romainrossi/make_your_robot_tick/contest rules/game field 3D view.png

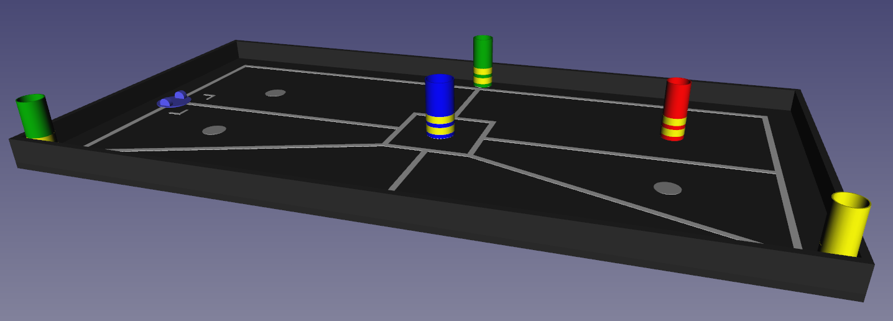
contest rules/game field 3D view.png
