romainrossi/make_your_robot_tick/contest rules/source 3D view.png

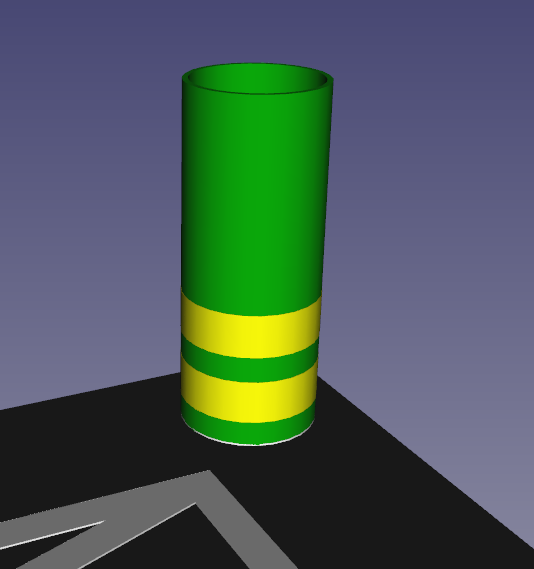
contest rules/source 3D view.png
