romainrossi/make_your_robot_tick/README.md

# Make Your Robot Tick

A robotic contest organized by [ESIGELEC](http://esigelec.fr/en).

# Status

The contest is now closed; thanks to all the participants.
