romainrossi/make_your_robot_tick/contest rules/README.md

# Make Your Robot Tick - Rules

This directory contains the official rules document and associated technical documentation : pictures, drawings and schematics of the game field elements.
