romainrossi/make_your_robot_tick/src/elec/README.md

# Make Your Robot Tick - Electronics CAD files

This directory contains a KiCAD project for the electronic boards used on the game field.
