romainrossi/make_your_robot_tick/src/meca/README.md

# Make Your Robot Tick - Mechanical CAD files

This directory contains a FreeCAD project design of the game field and associated elements.
