romainrossi/make_your_robot_tick/contest rules/source activation timing.pdf

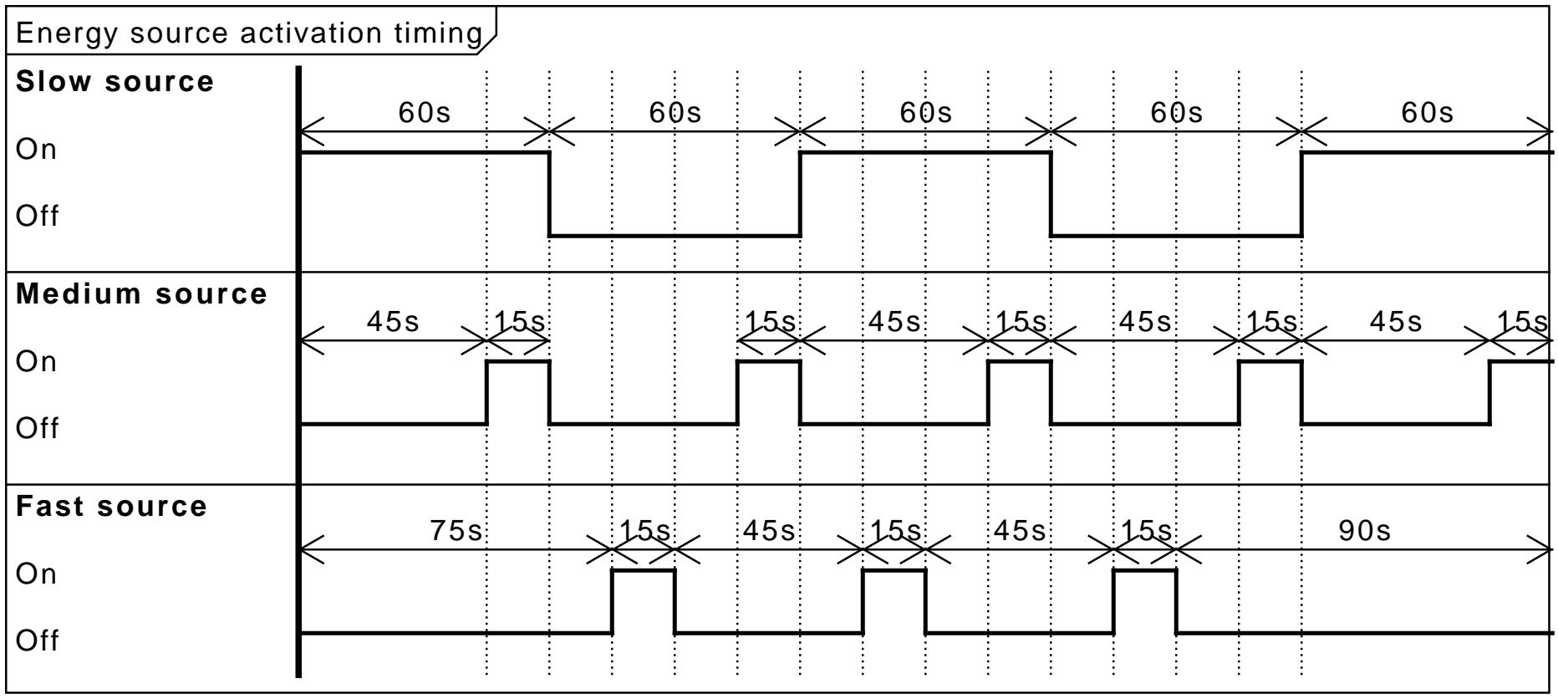
[picture p3: figure]
Energy source activation timing Slow source; Off; Medium source; Fast source
