romainrossi/make_your_robot_tick/src/meca/myrt.fcstd

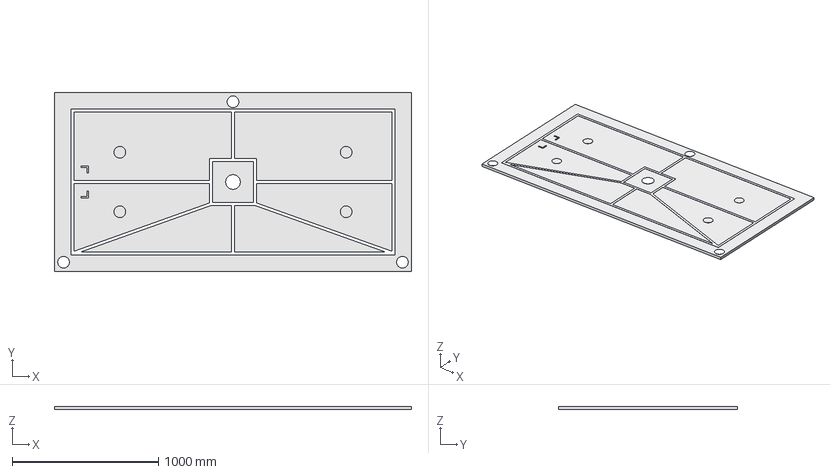
[picture p4: CAD file, 2017-11-25]
src/meca/myrt.fcstd
2440.0 x 1220.0 x 23.0 mm
Floor
Roads
LocationFastSource-marks
