romainrossi/make_your_robot_tick/(threads)

Thread 1 (2018-06-11):

Sample question about the rules for the organisation comitee

romainrossi, 2018-06-11:
# How to ask questions or make remarks about the rules

To ask question to the organisation team or give remarks, just create a new issue in the GitHub project.

In the content of your issue :
- Don't forget to add the "question" tag if your issue is a question
- Use the "bug" tag to report an error in the documents
- Choose a meaningful title, be precise and complete on your requests
- Before answering a question, always search if a similar question is not already asked
- Always be respectful in your questions or comments
- Cite the extract of the rulebook you refer to (example below)
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

# Answers

The MYRT organization team will give official answer to questions in batches about every weeks.
If enough modifications are made to the rules, a new version of the document will be published and will supersede the previous version.

Welcome on board and good luck !

romainrossi, 2018-07-06:
Test notifications

SachinGoud-24, 2018-09-03:
#question
Could you kindly provide details on the voltage levels of the charging stations? That would help us a lot in designing the storage system.

romainrossi, 2018-09-04:
Please, create your questions as new "Issues" and not as comment on existing one (especially a closed one).
Moreover, this question is already answered in another issue #4

SachinGoud-24, 2018-09-04:
Sorry for that, i shall ask my other questions as you have directed. Thank
you very much.

Regards,
S Sachin Goud

On Tue, Sep 4, 2018 at 1:46 PM Romain Rossi <notifications@github.com>
wrote:

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

Closed 2018-07-17.

Thread 3 (2018-07-16):

Power Sources and Competition Platform

me17b016, 2018-07-16:
In the pdf,it is not mentioned what will the voltage of power sources and also, please clarify the difference between the different types of power souces because in page 4 in the pdf,it is written that there will be three types of power sources -regular ,accelerated and fast but In page no.5,Graph of slow,medium and fast is given with their respective activation and deactivation timing,this is really confusing... and also please tell us about nature of energy storage station(ESS),that means, will the potential between the Terminals of ESS will increase with charging or not.
In competition platform,there is no white line towards fast power sources as we have in other types of power sources and also ,distance between energy storage station and it's very near white line is not mentioned,
And please tell us why you have given that the voltage between any two terminal of our robot must not go above 48 volts,why only 48 volts,why not 50 or any other number?

romainrossi, 2018-07-17:
Your question contain multiple items which I will answer separately for increased clarity.
I will link here the related issues.

romainrossi, 2018-07-17:
This question has been split into several issues which will be answered separately : #4 #5 #6 #7

Closed 2018-10-15.

Thread 4 (2018-07-17):

Voltage and characteristics of the power sources

romainrossi, 2018-07-17:
What is the voltage of the power sources ?

What are the differences between the different types of power souces ?
In page 4 of the RuleBook, it is written that there will be three types of power sources -regular ,accelerated and fast. But in page 5, Graph of slow,medium and fast is given with their respective activation and deactivation timing.

romainrossi, 2018-07-17:
The electric schematics of the power sources is available in the repository
https://github.com/romainrossi/make_your_robot_tick/blob/master/contest%20rules/electrical%20schematics.pdf

The power sources all provides **5V** and are each associated with a limiting resistor of different value to limit the delivered current.

Source | Limiting resistor | Max current
--- | --- | --- |
Normal | 500 | 10mA
Accelerated | 100 | 50mA
Fast | 33 | 150mA

In addition to this limit, each power source is activated according to a fixed schedule during the match. This schedule is available on figure 5 page 5.

You clearly spotted an inconsistency of the figure 5 page 5. The sources here are named "slow, medium, fast" while it should have been "regular, accelerated, fast" to agree with the remaining of the text.

Closed 2018-10-15.

Thread 5 (2018-07-17):

Nature of the Energy Storage Station

romainrossi, 2018-07-17:
What is the nature of energy storage station(ESS),that means, will the potential between the Terminals of ESS will increase with charging or not ?

romainrossi, 2018-07-17:
The Energy Storage Station is NOT a storage device at all. It's only purpose is to measure the amount of power harvested and delivered by your robot.

As such, the ESS consists of a dummy load (resistor) in series between the positive and negative copper contacts. This dummy load is used to measure the current and voltage delivered by your robot and, integrated with the time, the quantity of energy.

The design of the ESS is not finished yet, an update to the electric schematics in the repository will be done soon. The dummy load will be equivalent to a 100 ohms resistor.

romainrossi, 2018-09-05:
The electric schematics of the ESS is mostly done and can be seen in the repository (src/elec/myrt.sch).

Closed 2018-10-15.

Thread 6 (2018-07-17):

No white line to go to the fast power source

romainrossi, 2018-07-17:
In competition platform, there is no white line towards fast power sources as we have in other types of power sources. Why ?

romainrossi, 2018-07-17:
The fast charging station is intended to be more difficult to reach than the others stations, this is the reason why no white lines leading directly to it.

The fast charging station will be randomly placed at the start of each match on one of the four positions described on figure 4 (page 4).

Closed 2018-10-15.

Thread 7 (2018-07-17):

48V Voltage limit

romainrossi, 2018-07-17:
Why you have given that the voltage between any two terminal of our robot must not go above 48 volts, why only 48 volts, why not 50 or any other number ?

romainrossi, 2018-07-17:
The 48V limit is here for safety and legislation compliance.

Above 50V, an accidental contact can be deadly for a human being. Thus the safe voltage zones is below 50V.
We settled for 48V to allow for small safety margin in case of imperfect voltage regulation.

The rules clearly states "between any two terminals" on the robot, so if for some reason you robot generates -12V for your electronics, your most positive voltage cannot be higher than 36V.

Also, the rules indicates "During any time on the competition" and this also means outside of the playfield and not only during the match.

See https://en.wikipedia.org/wiki/Extra-low_voltage for more information.

Closed 2018-10-15.

Thread 8 (2018-07-17):

Position of the energy storage station relative to the white lines

romainrossi, 2018-07-17:
The distance between energy storage station and it's very near white line is not mentioned.

romainrossi, 2018-07-17:
This distance is indeed missing.
As a quick answer, here is a snapshot of the CAD with the distance :
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

Closed 2018-10-15.

Thread 10 (2018-09-04):

Will the total amount of charge collected be measured at the end of 5 minutes of the competition?

SachinGoud-24, 2018-09-04:
Should the bot reach the storage station only at the end or is it at the liberty of the team?

romainrossi, 2018-09-05:
The robot is free to reach the Energy Storage Station as often as needed during the match. Is is at the liberty of the team to choose a strategy to be able to collect and deliver as much energy as possible.
The energy counter starts at 0 and is increased each time the robot deliver energy to the ESS. The energy counter will never decrease during the match. The score takes into account the value of the energy counter at the end of the match.
As bonus points are awarded each time the robot connect to a power source or to the ESS, is seems preferable to deliver energy multiple times during the match. However, successive connection to the same item (source or ESS) will only be counted once.

Closed 2018-10-15.

Thread 11 (2018-09-07):

REGARDING LIPO 3.7V  with embedded NTC

Ganeshvadhri, 2018-09-07:
Where will we get a 3.7v lipo battery with embedded NTC?
It is mentioned in schematics of SAMboard that  we could short the GS pin if we want to connect a lipo battery without NTC, but we could not find the GS pin anywhere on the board.

romainrossi, 2018-09-10:
Due to safety problems, air-shipping of LiPo battery is now becoming very difficult and expensive. This is why the robot we provided don't have the embedded battery which we normally use.

To power the robot, you can use (by order of preference) :

1. A smartphone portable power bank (best method)
2. A LiPo battery pack with embedded NTC (best alternative)
3. A LiPo battery pack without NTC (discouraged)

**Solution 1** is easier, quicker and safer. A small and cheap smartphone power bank connected to the charging port of the SAMboard will be enough; provided it can output 5V at 1A (virtually all power banks can do that) and have a capacity of 1000 mA.h or more. I suggest you get two small power banks instead of a big one, so you can quickly swap it when it is depleted (instead of waiting to recharge it). The smallest power bank you can find should be ok thanks to the low power consumption of the robot.

**Solution 2** needs a battery pack of 3.7V, 1300mA.h with a 3 point connector. [Official LiPo battery we use on the SAMboard](https://fr.farnell.com/bak/lp-503759-is-3/batterie-lithium-pol-3-7v-1300/dp/2077882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). You need to pay attention to the connector (type and connections). The battery can be attached underneath the robot with adhesive pad. The battery is charged when 5V is supplied to the USB connector on the SAMboard.

**Solution 3** is discouraged. With a hardware modification of the SAMboard (removing the battery connector, replacing it with a 2 points connector, and shorting GS). The SAMboard can use a LiPo battery without NTC (2 points connector). The battery must have exactly this characteristics : 3.7V, 1300mA.h with the same size as the previous battery (see solution 2). This solution has not been tested.

Closed 2018-10-15.

Thread 12 (2018-09-10):

Using another processor as a master to control the SAM board and the MSP 430

mentalrecessmonkey, 2018-09-10:
Are we allowed to use an extra microprocessor in parallel to the SAM board to act as a master and control the whole bot?

romainrossi, 2018-09-13:
As stated by the section 3.3.1 in the Rule Book:
> All teams have to use the provided (micro-controller) board.
This statement was intended to enforce the constraint that the main processor is the MSP430 on the Launchpad board. Thus, the robot motion and main behavior must be controller by a software running on the MSP430, a very power-efficient micro-controller (the contest is about energy harvesting).

However, you can add any component you want on the additional board you develop (the energy harvesting system). So it is not forbidden to add a CPU of any kind on your add-on board to make processing alongside the MSP430. If you directly connect GPIO of your additional processor to the MSP or the SAMboard; pay attention to the voltage level to avoid destruction.

As an additional information, you can develop the embedded program for the MSP430 using any software toolkit you want :
- Code Composer Studio for raw C/C++
- Energia or Arduino for a higher-level perspective (see the PlatformIO toolbox)

Closed 2018-10-15.

Thread 14 (2018-09-21):

What is the diameter of the Energy Storage Station ?

romainrossi, 2018-09-21:
The diameter of ENERGY STORAGE STATION is not mentioned anywhere in the rule book; can you give it ?

romainrossi, 2018-09-21:
The Energy Storage Station (ESS) is made from a section of standard PVC pipe of external diameter 100mm.
Figure 3, page 4 of the RuleBook gives the dimension and diameters of the sources (the 4 sources have the same size); but we forgot to include the same dimensions for the ESS.

Recently, we decided to increase the height of both sources and ESS because of cabling constraints, but the diameter remains the same.

As a summary, the current size of these elements are :

- ESS : cylinder of 100mm diameter, 300mm height
- Sources : cylinder of 80mm diameter, 24.5 cm height

Closed 2018-10-15.

Thread 16 (2018-09-21):

Insufficient power

Ganeshvadhri, 2018-09-21:
We are using a Power Bank(5v ,1amp) to power the mobile base, but the power is not sufficient for both the motors as well as the sensors we are using . As an alternative we could not use a lipo battery with embedded NTC as it is not available for us. So can you give us some suggestions ?

romainrossi, 2018-09-21:
I suggest you start by measuring the actual current needed by your system by cutting a USB cord and inserting an Ampere meter on the 5V wire.
Once you have this measure, you can select a power bank with the appropriate output rating.

Closed 2018-10-15.

Thread 18 (2018-09-23):

LIMITING RESISTOR

Ganeshvadhri, 2018-09-23:
1) Does the limiting resistance vary for a source , or is it constant?
2) In the grading pattern it is given that , if the energy delivered by the fast charging station is completely delivered to the ESS 500 points are awarded respectively 250 points for the accelerated and 66 points for the regular station.So, how do you differentiate between how much energy is being delivered  from the 3 different sources to calculate the points

romainrossi, 2018-09-23:
The full electrical schematics are available in this github repository (directory src/elec). It's made with KiCAD, a free and open-source software.
As you can see on the schematics, each source is equipped with a different fixed resistor which will provide the different current settings. The current for each source is fixed; but remember sources are enabled with a given time-schedule during the match (see RuleBook Figure 5 page 5).

The Energy Storage System (ESS) gives points for each quantity of energy delivered. It can't know from which source the energy come from; and your robot can have charged to multiple sources before delivering energy to the ESS. However, the mathematical relationship between Energy and Points is calibrated in the ESS so that if your robot gather **all** the energy delivered by the Fast Source during the whole match and deliver it to the ESS, it will give 500 points. Based on the relative amount of energy delivered by the other sources, we can estimate the number of points.

Source | Limiting resistor | Max current | ON time | Quantity of energy (C) | Max points |
--- | --- | --- | ---| ---| ---|
Regular | 500 | 10mA | 240s | 2.4 | 176 |
Accelerated | 100 | 50mA | 75s | 3.75 | 275 |
Fast | 33 | 150mA | 45s | 6.81 | 500 (by calibration) |

Closed 2018-10-15.

Thread 19 (2018-09-23):

Tests on game fields

Ganeshvadhri, 2018-09-23:
The white line in the competition might give different IR values to which the IR gives with the white line we use for testing. So will there be time for IR CALIBRATION before the competition?
And are we allowed to test our bot on the platform before the competition ?

romainrossi, 2018-09-23:
The two game fields will be available for testing during the review of the robots in the morning, which should last for about 1h30. There will be additional testing time during the lunch break. All the teams will have to collaborate to share these time slots.

During the selection and final rounds, the game fields will be used full-time.

I strongly suggest you to develop a quick calibration procedure (<20 seconds), so you can perform and check your sensors calibration during the setup time at the start of each match.

This setup time will be short (1 to 2 minutes), so you need to be efficient.

Closed 2018-10-15.

Thread 20 (2018-09-24):

not clear how bot charges from the charging place

sanjayav, 2018-09-24:
Good morning
I have a doubt regarding the charging and discharging process by the energy harvesting system
Should It be a wireless charging and discharging  or else wired charging and discharging ???

romainrossi, 2018-09-25:
To charge and deliver energy to the Energy Storage System, tour robot can connect using 2 copper contacts placed on each source and the ESS.
The RuleBook describes the size and place of these copper contacts.

Closed 2018-10-15.

Thread 22 (2018-09-25):

bot charging

sanjayav, 2018-09-25:
How does the robot charge when I goes to a position of station any example pics

romainrossi, 2018-09-26:
I don't have example pictures.

Your robot should charge the embedded energy storage unit by connecting to the two copper contacts rings located on each source and the ESS.
I think using spring-loaded contacts to connect your robot to the devices is the best way.

See the pictures and schematics in the RuleBook : on Figure1, page3, you can see the copper rings wrapped around each source and the ESS in goldish color.
Figure 3 page 4 gives a detailed view of a source, and the associated schematics. Look especially for the height of each contact from the floor as you will need to adjust the height of the contacts on your robot to match.

Other issues giving information about ESS and sources : #3 #4 #5 #6  #8 #10 #14 #18

Closed 2018-10-15.

Thread 23 (2018-09-30):

EMERGENCY BUTTON

Ganeshvadhri, 2018-09-30:
It is mentioned in the rule book that for security reasons all robots must have an emergency button for the robot to come to halt instantly.
So, is it enough if the robot just comes to halt or should the power supply to the microcontroller be cut off?

romainrossi, 2018-09-30:
As stated in the RuleBook, rhe emergency stop button must stop the robot. If it do that, then it is ok.
You have no obligation to cut the power of the embedded controller or motors, just to halt the robot.

Closed 2018-10-15.

Thread 25 (2018-09-30):

When will the charging stations be powered on?

SachinGoud-24, 2018-09-30:
Will all the charging stations be switched on at once? At the beginning of the competition, and will follow the cycle mentioned in fig.5 of page 5, till the end of 5 minutes of the competition?

Also how long will the Energy storage station take to measure the charge collected by the bot?

romainrossi, 2018-09-30:
The sources are activated in each match according to the schedule of the figure 5. So at the beginning of the match, only the two "Slow/Regular" sources are enabled. The schedule of the figure 5 covers the whole duration of the match.

romainrossi, 2018-09-30:
The energy storage station counts the energy delivered by your robot. It is a 100ohms resistor and the current is measured and integrated to make the score. The more current your robot push in the 100ohms resistor, the faster you score points. In fact, your design will be what set the time to count the energy.

You can find the schematics in the repository, src/elec/ folder (Kicad 5 format)

Closed 2018-10-15.

Thread 26 (2018-10-02):

Regarding Discharging  of the bot

Ganeshvadhri, 2018-10-02:
If the Bot goes to an electrode which is not active at that time ,then will the energy harvesting circuit of the  robot discharge?
That is, will the circuit of the charging station break when it is not active?

romainrossi, 2018-10-03:
Yes, your energy storage system will discharge (slightly) if you connect it to a source which is not active. The discharge will be through the 470ohm resistor and led, so the current will be small.

As you have the complete schedule of the sources activations, I suggest you try to avoid this situation. You can also use the embedded ADC in the MSP430 to sense the activation of the source. You can also insert a diode in series to prevent discharge (you will the need to bypass it using eg a relay to deliver energy to the ESS).

Closed 2018-10-15.
