romainrossi/make_your_robot_tick/contest rules/electrical schematics.pdf

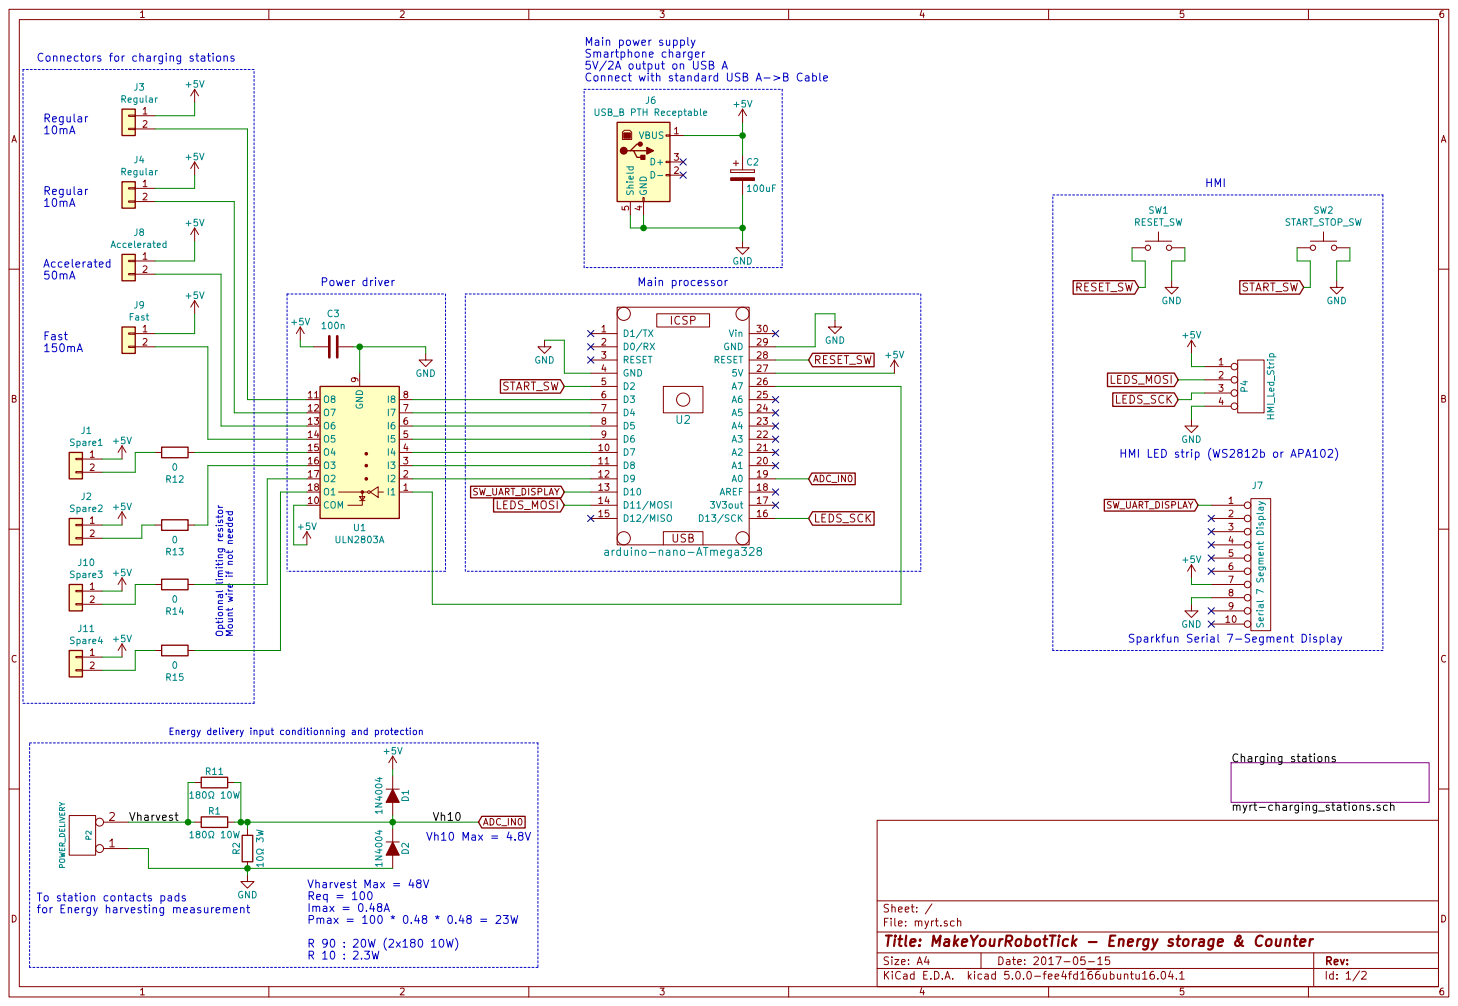
[picture p5: page 1]

+5V GND Main power supply
Smartphone charger
5V/2A output on USB A
Connect with standard USB A->B Cable
arduino-nano-ATmega328GND

Connectors for charging stations
J3 Regular 1
Regular 10mA
J4 Regular 1

HMI LED strip (WS2812b or APA102) +5V GND

Sparkfun Serial 7-Segment Display GND

To station contacts pads

File: myrt.sch Sheet: /
Id: 1/2 Title: MakeYourRobotTick - Energy storage & Counter

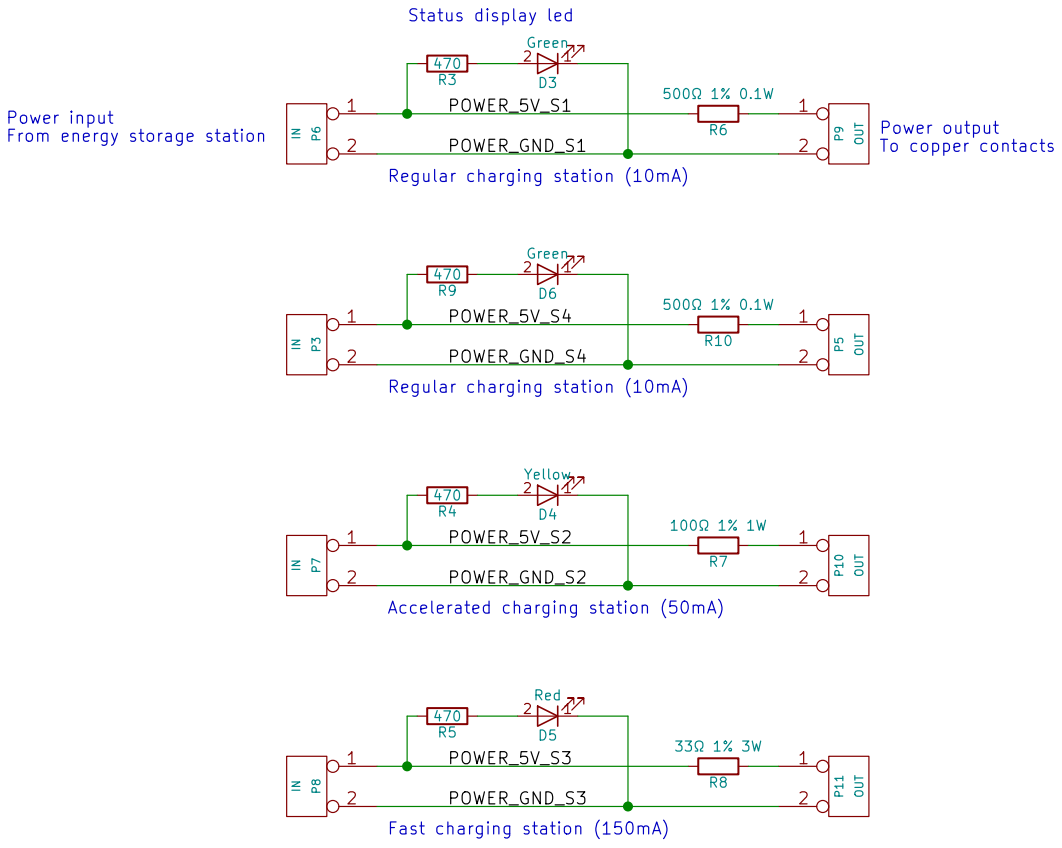
[picture p6: page 2]

Power input
From energy storage station
