romainrossi/make_your_robot_tick/contest rules/game field drawing.pdf

## m²⁰⁰,0 mm 80,0 mm

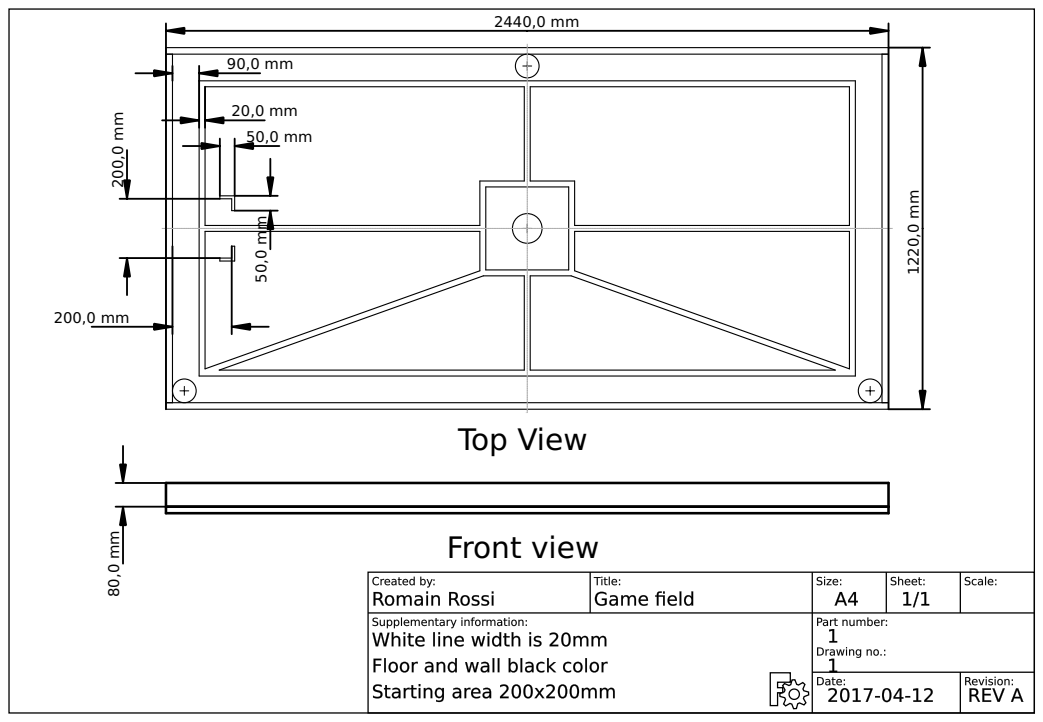
[picture p7: page 1]
Vie; Fro; nt vie
