romainrossi/make_your_robot_tick/sambot/SAMboard.pdf

SAM Board v3 – User Manual

Presentation
The SAMboard is a specific electronic boards developed by ESIGELEC especially for building a small differential robots based on the Pololu rrc04a chassis. It accepts a Texas Instruments Launchpad as a daughter board to be the brain of this robot.
This manual presents usage and setup of this board.

Functionalities

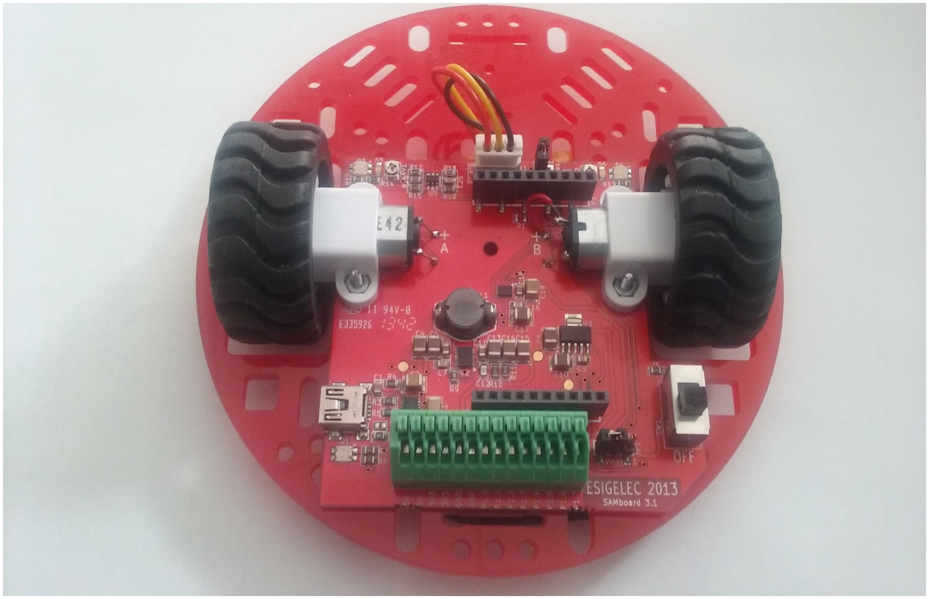
[picture p8: figure]

The SAMboard bring many functionalities to have a fully-functional robot :
- Battery management : charging and supervision of a single cell 3.7V LiPo battery
- Power management : voltage conversion from the battery to 5V and 3.3V
- DC motor control with a dual H bridge (TI DRV8835) and two optical incremental encoders (sensitivity can be tuned using RV1 and RV2)
- Female SIL connectors to plug a Launchpad board (the connectors on a stock Launchpad needs to be modified)
- A quick connector for easy sensor connection

### Figure 1: SAMboard v3 assembled on Pololu chassis

Jumpers configuration

Jumper | Description | Default Configuration | Other Configuration
JP1 | DC motors power supply | 1-2 : From battery (about 3.7V) Slower robot, but stronger immunity to sudden changes in speed | 2-3 : From 5V DC/DC converter Faster robot, but acceleration and decelerations ramps must be used to avoid overload of DC/DC converter and Launchpad reboot
JP2 | Optical incremental encoders | Jumper present : encoders ON, D3 and D4 shows the status | Jumper removed: encoders OFF, D3 et D4 can be controlled by the Launchpad

Connectors
K1 : 3 points connector, 2.54mm step; for 3.7V LiPo battery with embedded NTC.
K2 : 3 points, 2mm step, for 3.7V LiPo battery without embedded NTC. Located under K1 which needs to be removed in order to use K2.
J1 : mini-USB B type connector. Use it to power the system (5V only) and charge the battery.
P1, P3 : female connectors to plug a Launchpad board with MSP430G2553 micro-controller. On the launchpad, all the jumpers should be on their default positions. The signals between the SAMboard and the Launchpad are described in the following tabular :
Launchpad Pin Number | SAMboard function | Direction (from the Launchpad perspective)
P1.0-P1.7 | Connected on the extension connector (green) | Input or Output
P 2.0 | Motor A optical encoder | Input
P 2.1 | Motor A direction | Output
P 2.2 | Motor A speed control : PWM [0..100%] duty cycle , 250 KHz maximum frequency | Output
P 2.3 | Motor B optical encoder | Input
P 2.4 | Motor B speed control : PWM [0..100%] duty cycle , 250 KHz maximum frequency | Output
P 2.5 | Motor B direction | Output

P2 : Green quick connector, gives access to all MSP430 signal which are not used by SAMboard functions as well as 3.3V and 5V voltages. See the silkscreen printed on the board.

Indicators
D1 | Green : ON = a power supply is connected on J1.
| Orange : ON = the battery is charging, OFF = battery fully charged (or disconnected).
D2 : ON = the system is operating.
D2, D3 : Shows the rotation direction of each DC motor.
D5, D6 : Shows the optical encoder states. The sensitivity of the encoders can be ajusted with RV1 and RV2 to have 50% duty cycle. If JP2 is removed, these leds can be used as indicators.

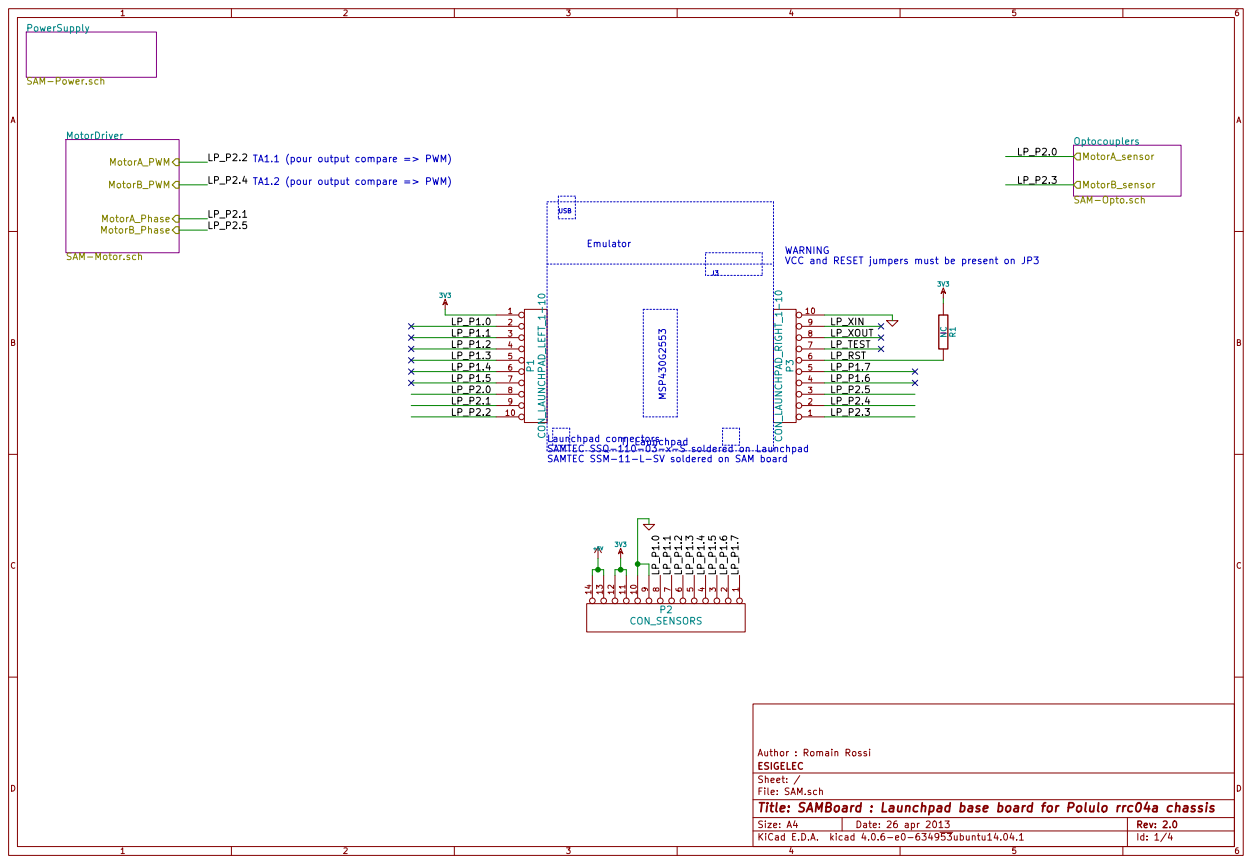
[picture p9: page 3]
D Date: 26 apr 2013 KiCad E.D.A. kicad 4.0.6-e0-634953ubuntu14.04.1 Size: A4; Rev: 2.0; 10 P¹ CON_LAUNCHPAD_LEFT_1⁻10; TI Launchpad; LP_RST; LP_TEST; LP_XOUT; LP_XIN; PowerSupply; MotorA_Phase; MotorA_PWM; MotorB_Phase; MotorB_PWM; USB; J3 Emulator; MSP⁴³⁰G²⁵⁵³; 10 P³ CON_LAUNCHPAD_RIGHT_1⁻10 14; 1 P2 CON_SENSORS; Optocouplers MotorA_sensor; - NCR¹

SAM-Power.sch MotorDriver SAM-Motor.sch

TA1.1 (pour output compare => PWM)

TA1.2 (pour output compare => PWM)

MotorB_sensor
SAM-Opto.sch

WARNING
VCC and RESET jumpers must be present on JP3

Launchpad connectors
SAMTEC SSQ-110-03-x-S soldered on Launchpad SAMTEC SSM-11-L-SV soldered on SAM board

Author : Romain Rossi
File: SAM.sch Sheet: / ESIGELEC

Id: 1/4 Title: SAMBoard : Launchpad base board for Polulo rrc04a chassis

22µ | VINA 1 | GND 2 | FB | 3 VOUT | 4 VOUT | 5
5V | TP3

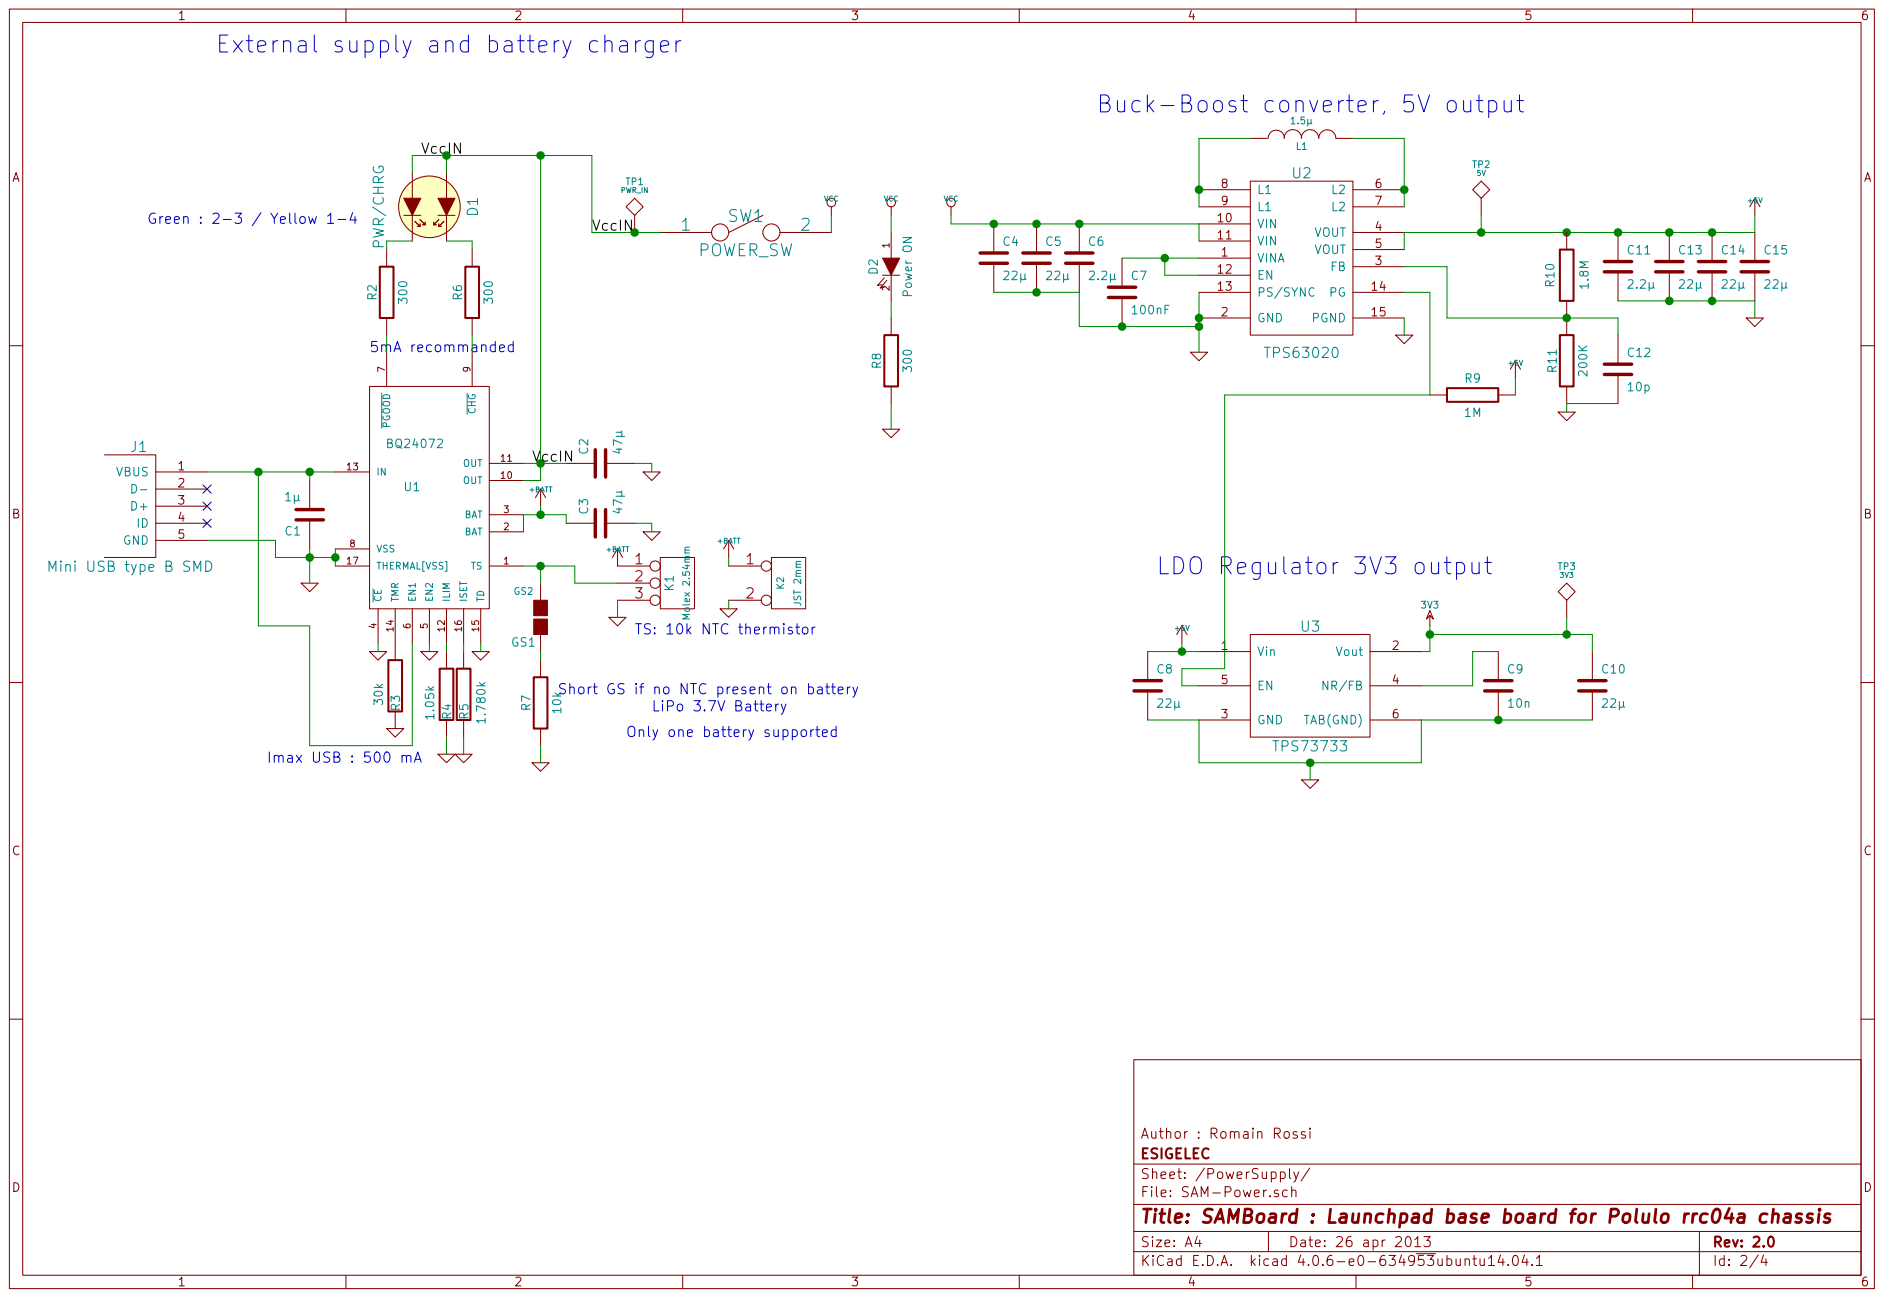
[picture p10: page 4]

External supply and battery charger 5mA recommanded C1

100nF Buck-Boost converter, 5V output

Only one battery supported

File: SAM-Power.sch Sheet: /PowerSupply/ ESIGELEC

Id: 2/4 Title: SAMBoard : Launchpad base board for Polulo rrc04a chassis

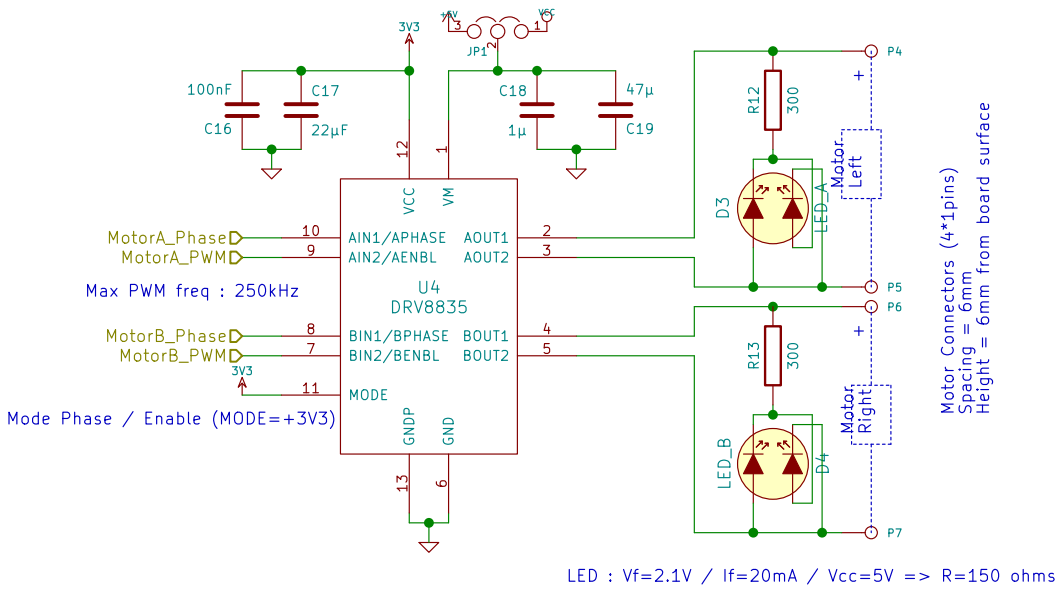
[picture p11: page 5]
D Date: 26 apr 2013 KiCad E.D.A. kicad 4.0.6-e0-634953ubuntu14.04.1 Size: A4; Rev: 2.0; VCC 3V3; 3V3 Mode Phase / Enable (MODE=+3V3); P4P5 R¹²; 47µ VM 1 AOUT1 2 AOUT2 3 BOUT1 4 BOUT2 5 GND; Motor Connectors ⁽4*1pins⁾ Spacing = 6mm Height = 6mm from board surface; 3 JP1 MotorA_Phase; MotorA_PWM; MotorB_Phase; MotorB_PWM; LED_A D⁴ LED_B; + R¹³

P6P7 Motor Left Motor Right

Max PWM freq : 250kHz C16

6 BIN2/BENBL 7 BIN1/BPHASE 8 AIN2/AENBL 9 AIN1/APHASE 10 MODE 11 VCC 12 GNDP 13 U4 DRV8835

LED : Vf=2.1V / If=20mA / Vcc=5V => R=150 ohms

Author : Romain Rossi
File: SAM-Motor.sch Sheet: /MotorDriver/ ESIGELEC

Id: 3/4 Title: SAMBoard : Launchpad base board for Polulo rrc04a chassis

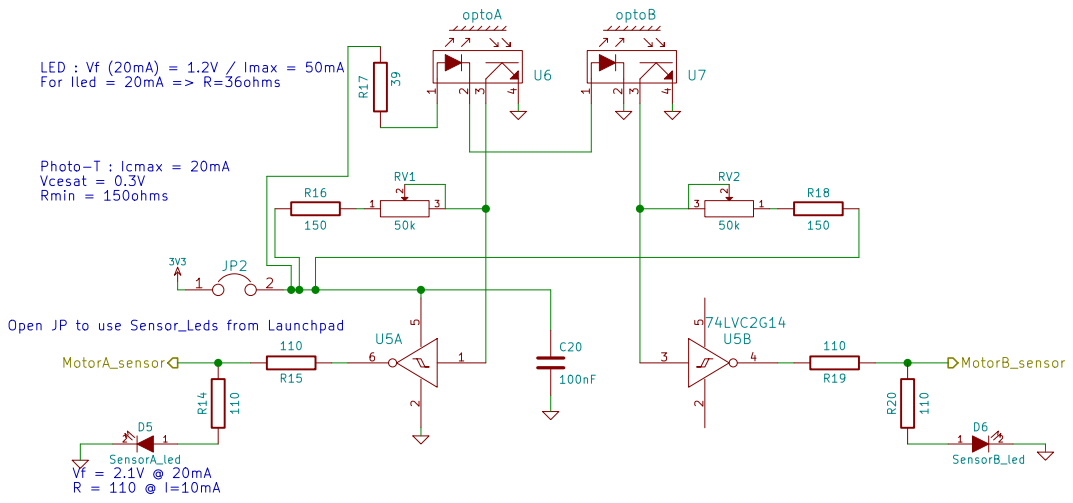
[picture p12: page 6]

150 LED : Vf (20mA) = 1.2V / Imax = 50mA
For Iled = 20mA => R=36ohms Photo-T : Icmax = 20mA

File: SAM-Opto.sch
Id: 4/4 Title: SAMBoard : Launchpad base board for Polulo rrc04a chassis
