romainrossi/make_your_robot_tick/contest rules/TableTop.pdf

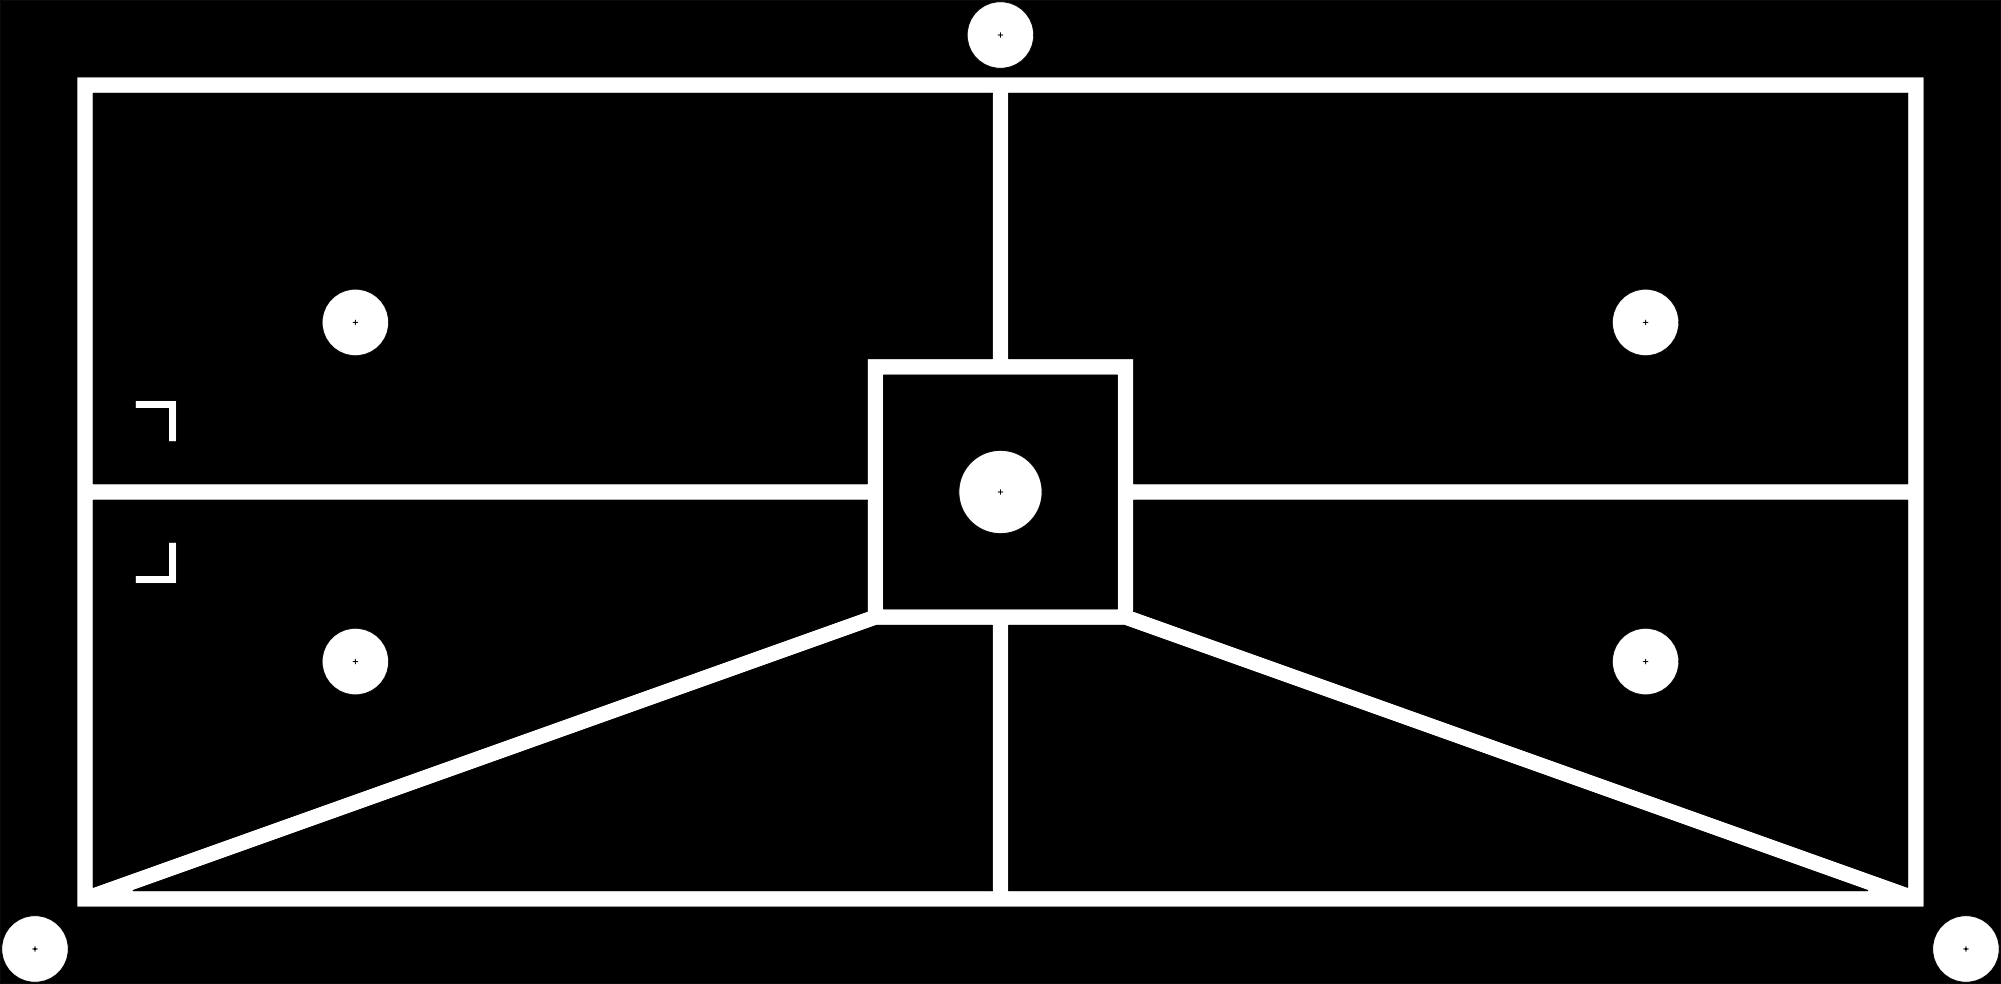
[picture p13: page 1]
