romainrossi/make_your_robot_tick/contest rules/source drawing.pdf

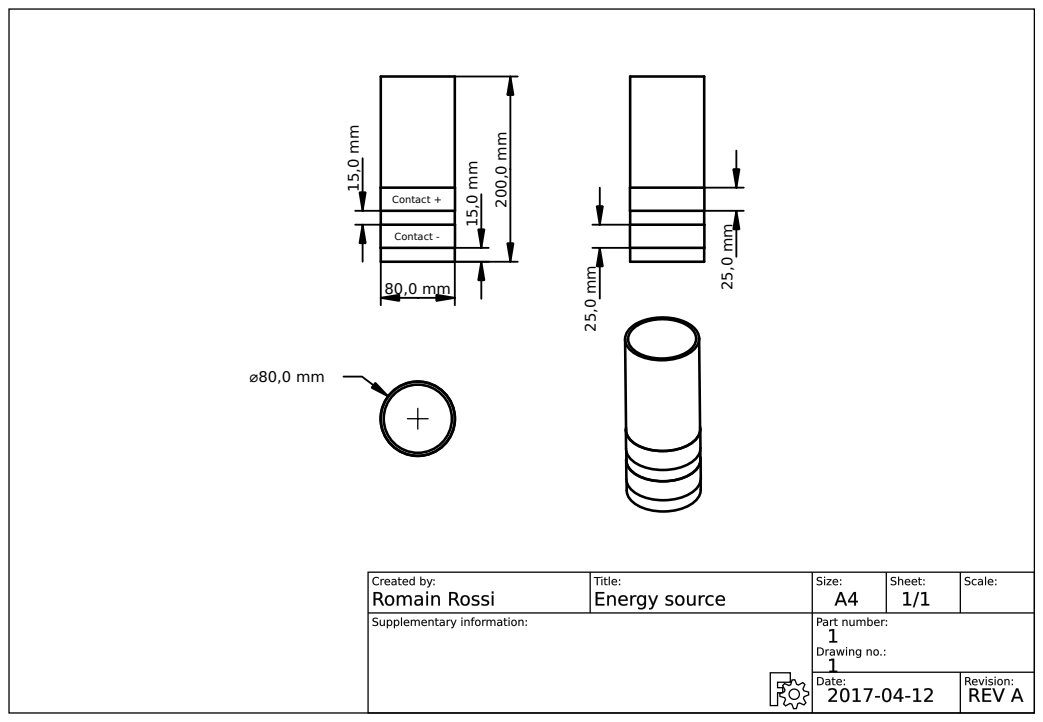
[picture p14: page 1]
nta
