romainrossi/make_your_robot_tick/contest rules/sources location on field.pdf

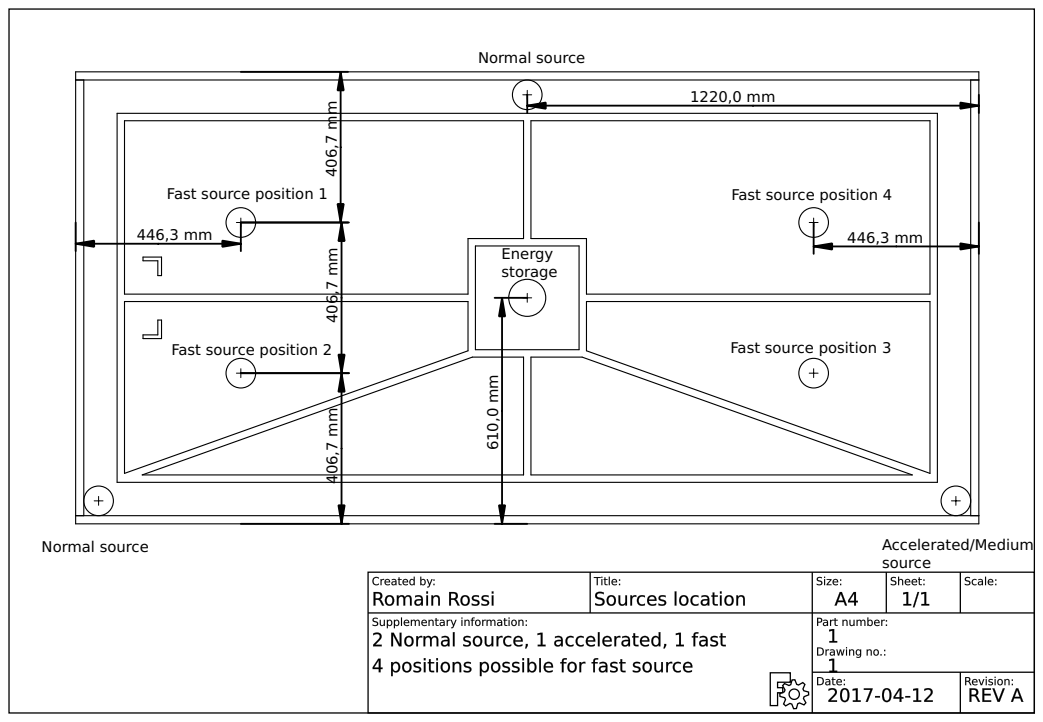
[picture p15: page 1]
Normal source; Accelerated/Medium; source; Energy storage; Fast source position 2; Fast source position 3

Fast source position 1

Fast source position 4
