romainrossi/make_your_robot_tick/src/elec/myrt.kicad_pcb

## KiCad design src/elec/myrt.kicad_pcb (2018-09-20)

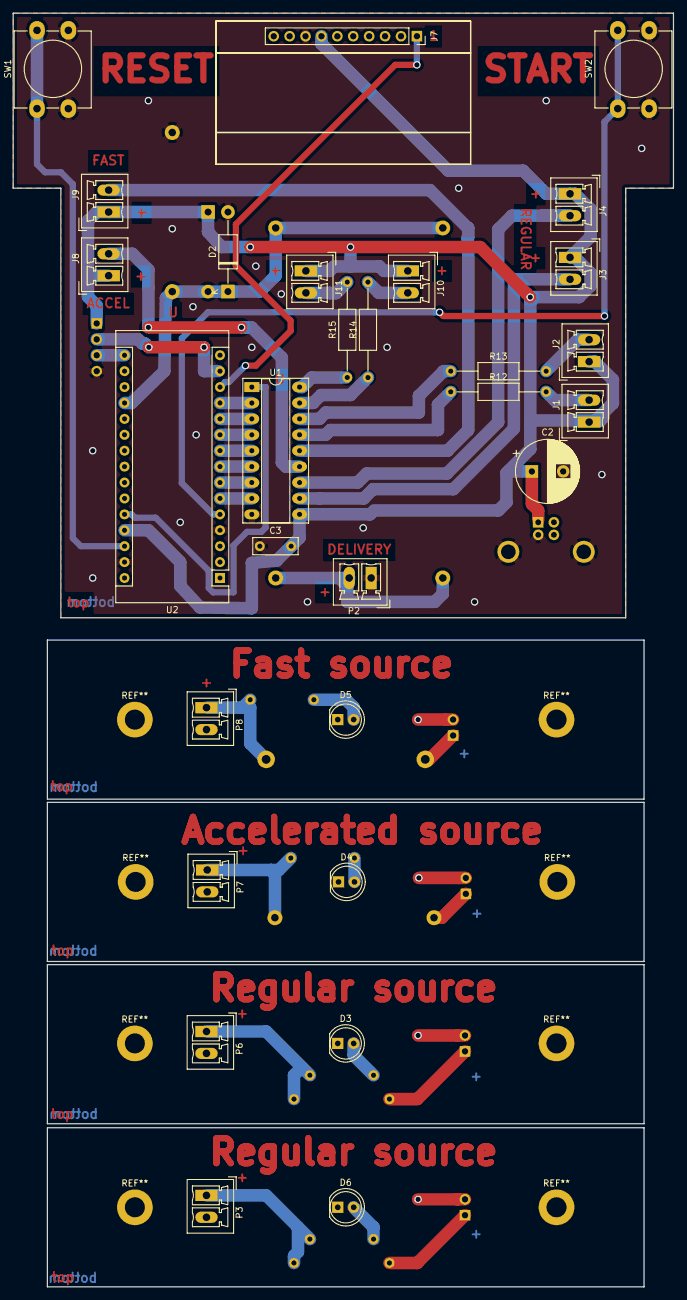
[picture p16: board myrt.kicad_pcb from above]

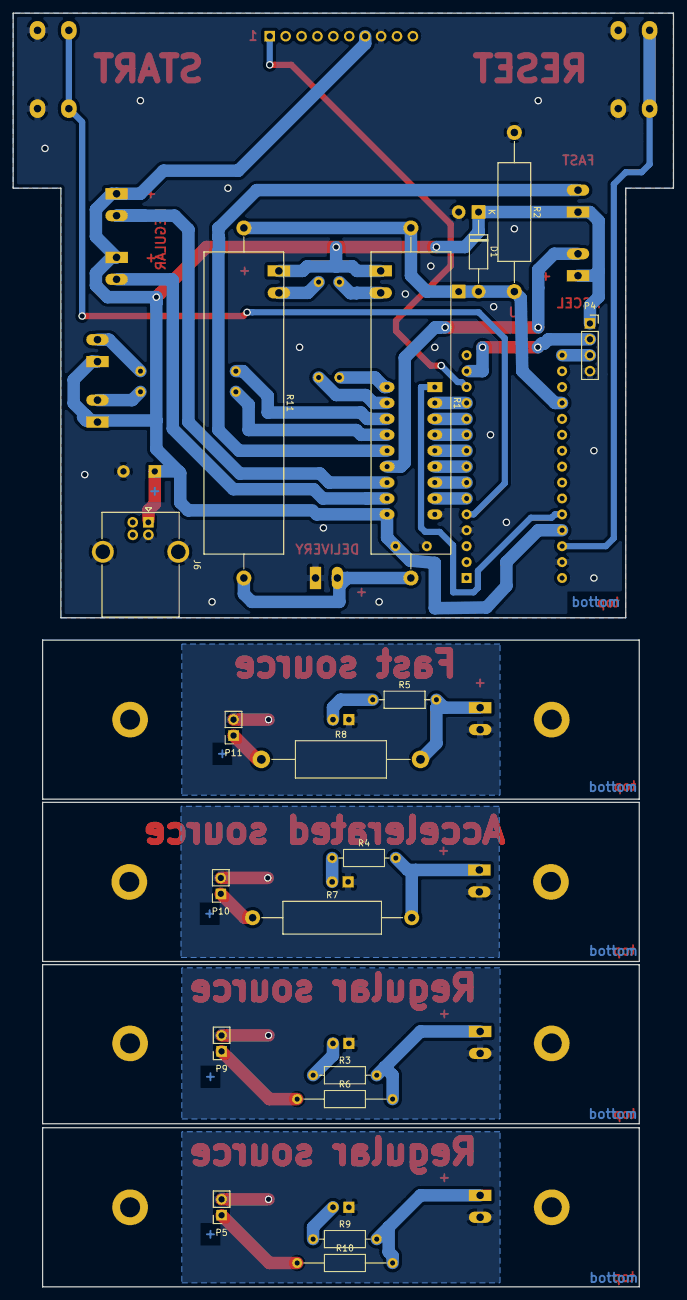
[picture p17: board myrt.kicad_pcb from below]

Board: 2 copper layers, 105.4 x 203.3 mm, 47 parts (18 on the bottom side), 45 nets.

Parts:
C2: 100uF; CP_Radial_D10.0mm_P5.00mm
C3: 100n; C_Rect_L7.0mm_W2.5mm_P5.00mm
D1, D2: 1N4004; D_DO-41_SOD81_P12.70mm_Horizontal
D3, D6: Green; LED_D5.0mm
D4: Yellow; LED_D5.0mm
D5: Red; LED_D5.0mm
J1: Spare1; PhoenixContact_MCV_1,5_2-G-3.5_1x02_P3.50mm_Vertical
J2: Spare2; PhoenixContact_MCV_1,5_2-G-3.5_1x02_P3.50mm_Vertical
J3, J4: Regular; PhoenixContact_MCV_1,5_2-G-3.5_1x02_P3.50mm_Vertical
J6: USB_B PTH Receptable; USB_B_OST_USB-B1HSxx_Horizontal
J7: Serial 7 Segment Display; PinSocket_1x10_P2.54mm_Vertical
J8: Accelerated; PhoenixContact_MCV_1,5_2-G-3.5_1x02_P3.50mm_Vertical
J9: Fast; PhoenixContact_MCV_1,5_2-G-3.5_1x02_P3.50mm_Vertical
J10: Spare3; PhoenixContact_MCV_1,5_2-G-3.5_1x02_P3.50mm_Vertical
J11: Spare4; PhoenixContact_MCV_1,5_2-G-3.5_1x02_P3.50mm_Vertical
P2: POWER_DELIVERY; PhoenixContact_MCV_1,5_2-G-3.5_1x02_P3.50mm_Vertical
P3, P6, P7, P8: IN; PhoenixContact_MCV_1,5_2-G-3.5_1x02_P3.50mm_Vertical
P4: HMI_Led_Strip; PinSocket_1x04_P2.54mm_Vertical
P5, P9, P10, P11: OUT; PinSocket_1x02_P2.54mm_Vertical
R1, R11: 180Ω 10W; R_Axial_Power_L48.0mm_W12.5mm_P55.88mm
R2: 10Ω 3W; R_Axial_DIN0516_L15.5mm_D5.0mm_P25.40mm_Horizontal
R3, R4, R5, R9: 470; R_Axial_DIN0207_L6.3mm_D2.5mm_P10.16mm_Horizontal
R6, R10: 500Ω 1% 0.1W; R_Axial_DIN0207_L6.3mm_D2.5mm_P15.24mm_Horizontal
R7: 100Ω 1% 1W; R_Axial_DIN0516_L15.5mm_D5.0mm_P25.40mm_Horizontal
R8: 33Ω 1% 3W; R_Axial_DIN0614_L14.3mm_D5.7mm_P25.40mm_Horizontal
R12, R13, R14, R15: 0; R_Axial_DIN0207_L6.3mm_D2.5mm_P15.24mm_Horizontal
SW1: RESET_SW; SW_PUSH-12mm_Wuerth-430476085716
SW2: START_STOP_SW; SW_PUSH-12mm_Wuerth-430476085716
U1: ULN2803A; DIP-18_W7.62mm_Socket_LongPads
U2: arduino-nano-ATmega328; Arduino_Nano

Connections:
+5V: C2.1, C3.2, D1.1, J1.1, J2.1, J3.1, J4.1, J6.1, J7.7, J8.1, J9.1, J10.1, J11.1, P4.1, U1.10, U2.27
/Charging stations/POWER_5V_S1: P6.1, R3.2, R6.2
/Charging stations/POWER_5V_S2: P7.1, R4.2, R7.2
/Charging stations/POWER_5V_S3: P8.1, R5.2, R8.2
/Charging stations/POWER_5V_S4: P3.1, R9.2, R10.2
/Charging stations/POWER_GND_S1: D3.1, P6.2, P9.2
/Charging stations/POWER_GND_S2: D4.1, P7.2, P10.2
/Charging stations/POWER_GND_S3: D5.1, P8.2, P11.2
/Charging stations/POWER_GND_S4: D6.1, P3.2, P5.2
/Vharvest: P2.2, R1.2, R11.2
ADC_IN0: D1.2, D2.1, R1.1, R2.2, R11.1, U2.19
GND: C2.2, C3.1, D2.2, J6.4, J6.5, J7.8, P2.1, P4.4, R2.1, SW1.2, SW2.2, U1.9, U2.4, U2.29
LEDS_MOSI: P4.2, U2.14
LEDS_SCK: P4.3, U2.16
unnamed: D3.2, R3.1
unnamed: D4.2, R4.1
unnamed: D5.2, R5.1
unnamed: D6.2, R9.1
unnamed: J1.2, R12.2
unnamed: J2.2, R13.2
unnamed: J3.2, U1.11
unnamed: J4.2, U1.12
unnamed: J8.2, U1.13
unnamed: J9.2, U1.14
unnamed: J10.2, R14.2
unnamed: J11.2, R15.2
unnamed: P5.1, R10.1
unnamed: P9.1, R6.1
unnamed: P10.1, R7.1
unnamed: P11.1, R8.1
unnamed: R12.1, U1.15
unnamed: R13.1, U1.16
unnamed: R14.1, U1.17
unnamed: R15.1, U1.18
unnamed: U1.1, U2.26
unnamed: U1.2, U2.12
unnamed: U1.3, U2.11
unnamed: U1.4, U2.10
unnamed: U1.5, U2.9
unnamed: U1.6, U2.8
unnamed: U1.7, U2.7
unnamed: U1.8, U2.6
RESET_SW: SW1.1, U2.28
START_SW: SW2.1, U2.5
SW_UART_DISPLAY: J7.1, U2.13
