romainrossi/make_your_robot_tick/(commit log)

2017-05-30 Initial publication
    [myrt-charging_stations.sch, myrt.fcstd, myrt.kicad_pcb, myrt.sch]
2017-11-25 Added drawing of the table surface in CAD
    [myrt.fcstd]
2017-11-25 Updated drawing in CAD
    [myrt.fcstd]
2018-08-27 Start PCB design
    [myrt-charging_stations.sch, myrt.kicad_pcb, myrt.sch]
2018-09-04 Massive update of the electrical schematics (Completion of schematics + upgrade to KiCAD 5.0)
    Schematics nearly complete, some components references are missing.
    The PCB however is still a draft.
    [myrt-charging_stations.sch, myrt.kicad_pcb, myrt.sch]
2018-09-13 PCB creation and update after first prototype built
    [myrt-charging_stations.sch, myrt.kicad_pcb, myrt.sch]
2018-09-13 Start of firmware development (Arduinowith PlatformIO
2018-09-13 Added power-source activation control
2018-09-14 Deleted useless component (C), minor changes after tests
    [myrt.kicad_pcb, myrt.sch]
2018-09-17 Added calibration procedure
2018-09-17 Finish calibration procedure
2018-09-17 Store and Load calibration data to/from EEPROM
2018-09-17 Last changes on the PCB before production
    [myrt.kicad_pcb]
2018-09-20 Perform a factory reset of the display on setup entry
    [main.cpp]
2018-09-20 Added via to ease soldering of energy source copper rings connector
    [myrt.kicad_pcb]
2018-09-29 Correction of incorrect display of first message
    [main.cpp]
2018-10-01 Updated PDF export of the electrical schematics
2018-10-01 Changed output directory for schematics editor plots
